eagletrt/bms-monitor/bms_monitor.kicad_pcb

## KiCad design bms_monitor.kicad_pcb (2023-05-23)

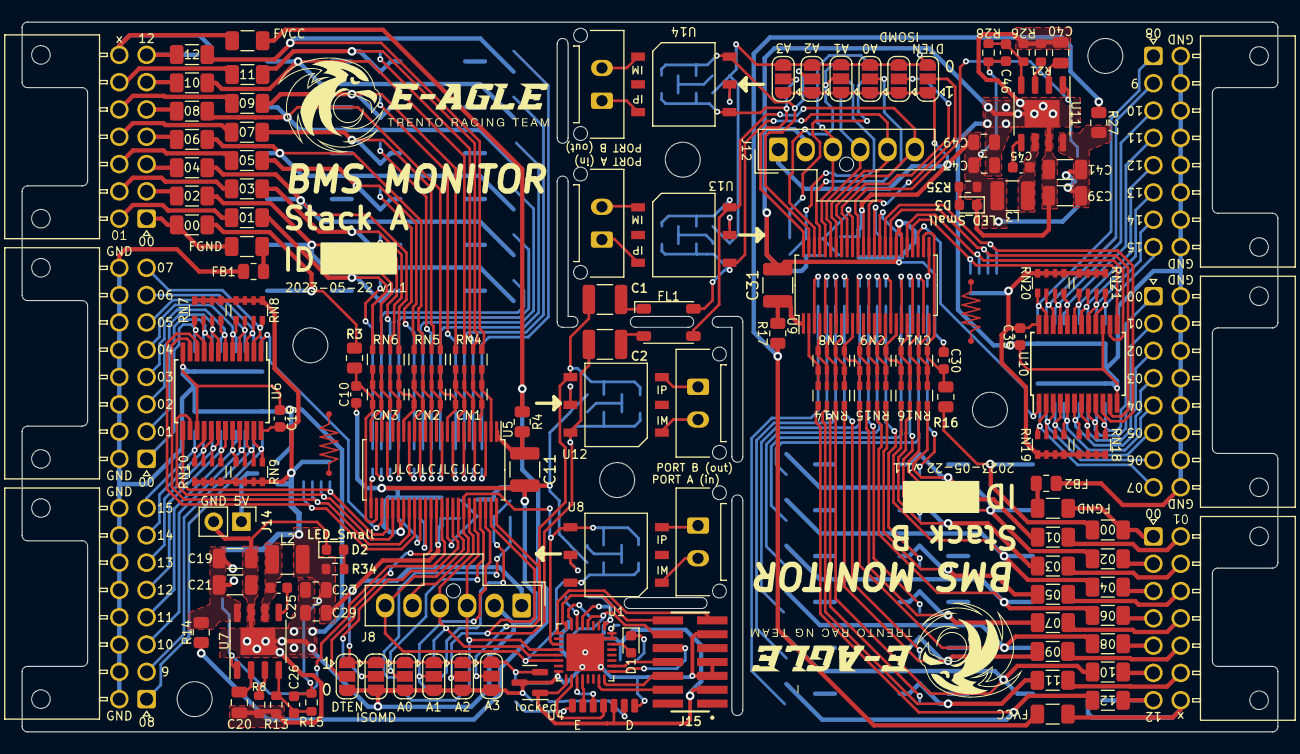
[picture p1: board bms_monitor.kicad_pcb from above]

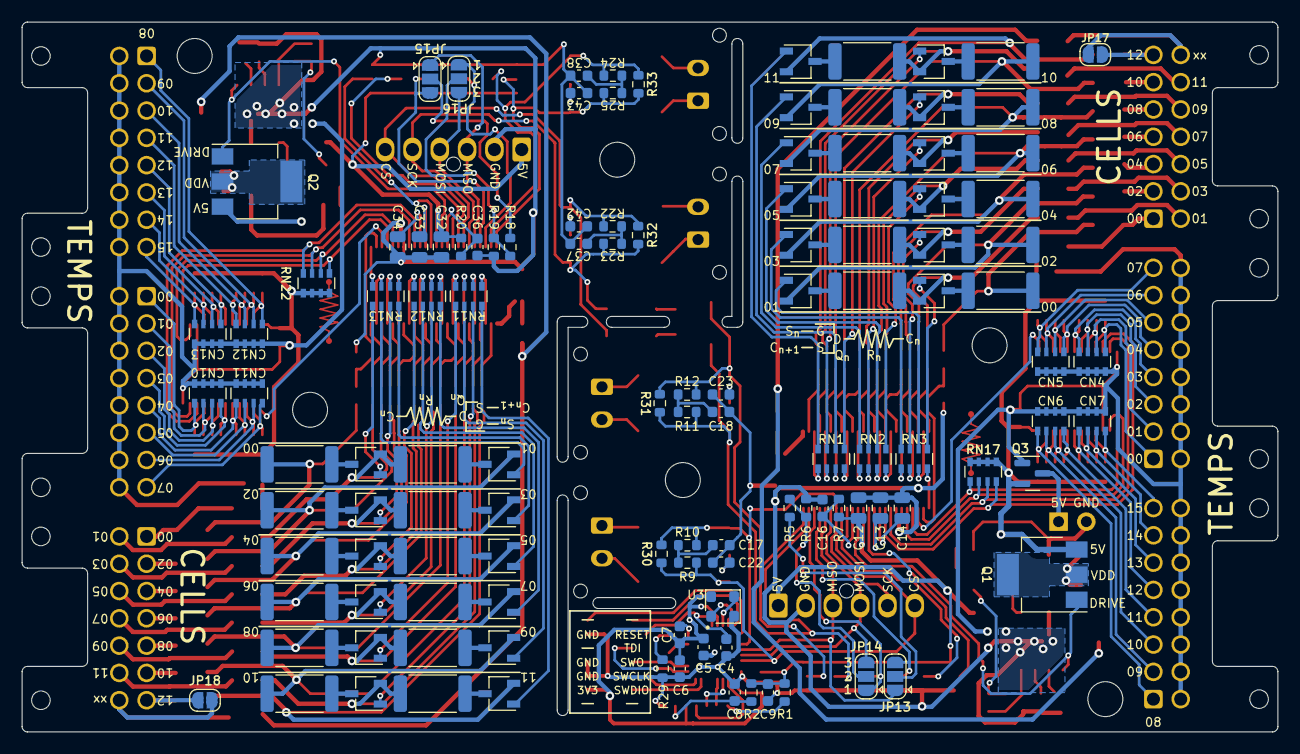
[picture p2: board bms_monitor.kicad_pcb from below]

Board: 2 copper layers, 115.0 x 65.0 mm, 256 parts (117 on the bottom side), 286 nets.

Parts:
C1, C2: 10nF 100V; C_1210_3225Metric
C4, C5, C6, C7, C8, C9, C15, C25, C35, C45: 100nF; C_0603_1608Metric
C10, C17, C18, C22, C23, C30, C37, C38, C42, C43: 10nF; C_0603_1608Metric
C11, C31: 100nF 100V; C_1210_3225Metric
C12, C13, C14, C20, C32, C33, C34, C40: 1uF; C_0805_2012Metric
C16, C36: F; C_0603_1608Metric
C19, C21, C39, C41: 1uF 100V; C_1206_3216Metric
C26, C46: 680pF; C_0603_1608Metric
C27, C29, C47, C49: 10uF; C_0805_2012Metric
CN1, CN2, CN3, CN8, CN9, CN14: 10nF; R_Array_Convex_4x0603
CN4, CN5, CN6, CN7, CN10, CN11, CN12, CN13: 100nF; R_Array_Convex_4x0603
D1: LED; LED_0603_1608Metric
D2, D3: LED_Small; LED_0603_1608Metric
F13, F14, F15, F16, F17, F18, F19, F20, F21, F22, F23, F24, F25: 2A; Fuse_1206_3216Metric
FB1, FB2: 600R; R_0805_2012Metric
FL1: ACT45B-101-2P-TL003; ACT45B-xxx-2P-TL003
Fa0, Fa1, Fa2, Fa3, Fa4, Fa5, Fa6, Fa7, Fa8, Fa9, Fa10, Fa11, Fa12, Fa13, Fa14: 2A; Fuse_1206_3216Metric
Fb3, Fb14: 2A; Fuse_1206_3216Metric
H1, H2, H3, H4, H5, H6: MountingHole; MountingHole_3.2mm_M3_ISO14580
J1, J2, J3, J4: Conn_01x02; Molex_Micro-Fit_3.0_43650-0215_1x02_P3.00mm_Vertical
J5, J9: CELLS; Molex_Nano-Fit_105314-xx14_2x07_P2.50mm_Horizontal
J6, J10: TEMP0; Molex_Nano-Fit_105314-xx16_2x08_P2.50mm_Horizontal
J7, J11: TEMP1; Molex_Nano-Fit_105314-xx16_2x08_P2.50mm_Horizontal
J8, J12: Conn_01x05; Molex_Nano-Fit_105309-xx06_1x06_P2.50mm_Vertical
J14: 5V; PinHeader_1x02_P2.54mm_Vertical
J15: Conn_ST_STDC14; SAMTEC_FTSH-107-01-L-DV-K-TR
JP1, JP7: A0; SolderJumper-3_P1.3mm_Open_RoundedPad1.0x1.5mm
JP2, JP8: A1; SolderJumper-3_P1.3mm_Open_RoundedPad1.0x1.5mm
JP3, JP9: A2; SolderJumper-3_P1.3mm_Open_RoundedPad1.0x1.5mm
JP4, JP10: A3; SolderJumper-3_P1.3mm_Open_RoundedPad1.0x1.5mm
JP5, JP11: DTEN; SolderJumper-3_P1.3mm_Open_RoundedPad1.0x1.5mm
JP6, JP12: ISOMD; SolderJumper-3_P1.3mm_Open_RoundedPad1.0x1.5mm
JP13, JP15: IBIAS; SolderJumper-3_P1.3mm_Open_RoundedPad1.0x1.5mm
JP14, JP16: ICMP; SolderJumper-3_P1.3mm_Open_RoundedPad1.0x1.5mm
JP17, JP18: isoIP; SolderJumper-2_P1.3mm_Open_RoundedPad1.0x1.5mm
L2, L3: 33uH; L_1210_3225Metric
Q1, Q2: NSS1C201MZ4; SOT-223
Q3: PMV65XP; SOT-23
Qda0, Qda1, Qda2, Qda3, Qda4, Qda5, Qda6, Qda7, Qda8, Qda9, Qda10, Qda11: BSS308PE; TSOT-23
Qdb0, Qdb1, Qdb2, Qdb3, Qdb4, Qdb5, Qdb6, Qdb7, Qdb8, Qdb9, Qdb10, Qdb11: BSS308PE; TSOT-23
R1, R2: 47R; R_0603_1608Metric
R3, R4, R14, R16, R17, R27: 100R; R_0805_2012Metric
R5, R6, R7, R18, R19, R20, R29: R; R_0603_1608Metric
R8, R21: 82k; R_0603_1608Metric
R9, R10, R11, R12, R22, R23, R24, R25: 51R; R_0603_1608Metric
R13, R26: 10k; R_0603_1608Metric
R15, R28: 39k; R_0603_1608Metric
R30, R31, R32, R33: 100; R_0603_1608Metric
R34, R35: 1K; R_0603_1608Metric
RN1, RN2, RN3, RN11, RN12, RN13: 3.3K; R_Array_Convex_4x0603
RN4, RN5, RN6, RN14, RN15, RN16: 100R; R_Array_Convex_4x0603
RN7, RN8, RN9, RN10, RN18, RN19, RN20, RN21: 27K; R_Array_Convex_4x0603
RN17, RN22: 10K; R_Array_Convex_4x0603
Rda0, Rda1, Rda2, Rda3, Rda4, Rda5, Rda6, Rda7, Rda8, Rda9, Rda10, Rda11: 10R; R_2512_6332Metric
Rdb0, Rdb1, Rdb2, Rdb3, Rdb4, Rdb5, Rdb6, Rdb7, Rdb8, Rdb9, Rdb10, Rdb11: 10R; R_2512_6332Metric
U1: STM32L432KBUx; QFN-32-1EP_5x5mm_P0.5mm_EP3.45x3.45mm
U3: DSC61XX; VLGA-4_2x2.5mm_P1.65mm
U4: TFBS4652
U5, U9: LTC6811-1; SSOP-48_5.3x12.8mm_P0.5mm
U6, U10: 74HC4067PW,118; SSOP-24_5.3x8.2mm_P0.65mm
U7, U11: MP4541; SOIC-8-1EP_3.9x4.9mm_P1.27mm_EP2.514x3.2mm
U8, U12, U13, U14: SM91502ALA
locked: MCP1812AT-033-TT; SOT-23

Connections:
+3.3V: C5.1, C6.1, C7.1, J15.3 (VCC), U1.1 (VDD), U1.5 (VDDA), U1.17 (VDD), U3.4 (VDD), U4.5 (VCCIO), locked.1 (Vout)
+5V: C9.1, C12.2, C15.2, C26.1, C27.1, C29.1, J8.1, JP1.1 (A), JP2.1 (A), JP3.1 (A), JP4.1 (A), JP5.1 (A), JP6.1 (A), L2.2, Q1.3 (E), Q3.2 (S), R1.2, R2.2, R7.1, R15.1, R34.1, RN7.1 (R1.1), RN7.2 (R2.1), RN7.3 (R3.1), RN7.4 (R4.1), RN8.1 (R1.1), RN8.2 (R2.1), RN8.3 (R3.1), RN8.4 (R4.1), RN9.1 (R1.1), RN9.2 (R2.1), RN9.3 (R3.1), RN9.4 (R4.1), RN10.1 (R1.1), RN10.2 (R2.1), RN10.3 (R3.1), RN10.4 (R4.1), RN17.1 (R1.1), RN17.2 (R2.1), RN17.3 (R3.1), RN17.4 (R4.1), U5.37 (VREG), U6.24 (VCC), locked.2 (Vin)
/CLK: U1.6 (PA0), U3.3 (OUT)
/CS: J8.6, R9.1, R30.1, U1.14 (PB0), U5.41 (CSB(IMA)), U8.6
/IA+_A: J8.5, R10.2, R30.2, U1.11 (PA5), U5.42 (SCK(IPA)), U8.4
/IAC_A: C22.2, U8.5
/IB+_B: JP10.2 (C), R25.2, R33.2, U9.48 (IPB), U14.4
/IB-_B: JP9.2 (C), R24.1, R33.1, U9.47 (IMB), U14.6
/IBC_B: C43.2, U14.5
/MISO: J8.3, JP13.1 (A), U1.12 (PA6), U5.44 (SDO(NC))
/MOSI: J8.4, JP14.3 (B), U1.13 (PA7), U5.43 (SDI(NC))
/STACK_A_IA+: J3.1, U8.3
/STACK_A_IA-: J3.2, U8.1
/STACK_A_IB+: J4.1, U12.3
/STACK_A_IB-: J4.2, U12.1
/STACK_B_IA+: J1.1, U13.3
/STACK_B_IA-: J1.2, U13.1
/STACK_B_IB+: J2.1, U14.3
/STACK_B_IB-: J2.2, U14.1
/SWCLK: J15.6 (JCLK/SWCLK), U1.24 (PA14)
/SWDIO: J15.4 (JTMS/SWDIO), U1.23 (PA13)
/SWO: J15.8 (JTDO/SWO), U1.26 (PB3)
/StackA/A0: JP1.2 (C), JP13.3 (B), U5.45 (IBIAS)
/StackA/A1: JP2.2 (C), JP14.1 (A), U5.46 (ICMP)
/StackA/A2: C2.1, JP3.2 (C), R11.1, R31.1, U5.47 (IMB), U12.6
/StackA/A3: C1.1, JP4.2 (C), R12.2, R31.2, U5.48 (IPB), U12.4
/StackA/C00: C10.2, CN3.1 (R1.1), R3.2, U5.26 (C0)
/StackA/C01: CN3.2 (R2.1), CN3.8 (R1.2), RN6.1 (R1.1), U5.24 (C1)
/StackA/C02: CN3.3 (R3.1), CN3.7 (R2.2), RN6.2 (R2.1), U5.22 (C2)
/StackA/C03: CN3.4 (R4.1), CN3.6 (R3.2), RN6.3 (R3.1), U5.20 (C3)
/StackA/C04: CN2.1 (R1.1), CN3.5 (R4.2), RN6.4 (R4.1), U5.18 (C4)
/StackA/C05: CN2.2 (R2.1), CN2.8 (R1.2), RN5.1 (R1.1), U5.16 (C5)
/StackA/C06: CN2.3 (R3.1), CN2.7 (R2.2), RN5.2 (R2.1), U5.14 (C6)
/StackA/C07: CN2.4 (R4.1), CN2.6 (R3.2), RN5.3 (R3.1), U5.12 (C7)
/StackA/C08: CN1.1 (R1.1), CN2.5 (R4.2), RN5.4 (R4.1), U5.10 (C8)
/StackA/C09: CN1.2 (R2.1), CN1.8 (R1.2), RN4.1 (R1.1), U5.8 (C9)
/StackA/C10: CN1.3 (R3.1), CN1.7 (R2.2), RN4.2 (R2.1), U5.6 (C10)
/StackA/C11: CN1.4 (R4.1), CN1.6 (R3.2), RN4.3 (R3.1), U5.4 (C11)
/StackA/C12: CN1.5 (R4.2), RN4.4 (R4.1), U5.2 (C12)
/StackA/CC00: Fa0.1, R3.1, Rda0.2
/StackA/CC01: Fa1.1, Qda0.2 (S), RN6.8 (R1.2), Rda1.2
/StackA/CC02: Fa2.1, Qda1.2 (S), RN6.7 (R2.2), Rda2.2
/StackA/CC03: Fa3.1, Qda2.2 (S), RN6.6 (R3.2), Rda3.2
/StackA/CC04: Fa4.1, Qda3.2 (S), RN6.5 (R4.2), Rda4.2
/StackA/CC05: Fa5.1, Qda4.2 (S), RN5.8 (R1.2), Rda5.2
/StackA/CC06: Fa6.1, Qda5.2 (S), RN5.7 (R2.2), Rda6.2
/StackA/CC07: Fa7.1, Qda6.2 (S), RN5.6 (R3.2), Rda7.2
/StackA/CC08: Fa8.1, Qda7.2 (S), RN5.5 (R4.2), Rda8.2
/StackA/CC09: Fa9.1, Qda8.2 (S), RN4.8 (R1.2), Rda9.2
/StackA/CC10: Fa10.1, Qda9.2 (S), RN4.7 (R2.2), Rda10.2
/StackA/CC11: Fa11.1, Qda10.2 (S), RN4.6 (R3.2), Rda11.2
/StackA/CC12: Fa12.1, Qda11.2 (S), RN4.5 (R4.2)
/StackA/DRIVE: Q1.1 (B), U5.38 (DRIVE), U7.1 (EN)
/StackA/DTEN: JP5.2 (C), U5.36 (SWTEN)
/StackA/IBC: C23.2, U12.5
/StackA/ISOMD: JP6.2 (C), U5.40 (ISOMD)
/StackA/MUX_A0: RN17.8 (R1.2), U5.33 (GPIO5), U6.10 (S0)
/StackA/MUX_A1: RN17.7 (R2.2), U5.32 (GPIO4), U6.11 (S1)
/StackA/MUX_A2: RN17.6 (R3.2), U5.29 (GPIO3), U6.14 (S2)
/StackA/MUX_A3: RN17.5 (R4.2), U5.28 (GPIO2), U6.13 (S3)
/StackA/MUX_OUT: U5.27 (GPIO1), U6.1 (COM)
/StackA/PSU_INPUT: C19.1, C21.1, Q1.2 (C), Q1.4 (C), R14.2, U7.8 (VIN)
/StackA/S00: RN3.8 (R1.2), U5.25 (S1)
/StackA/S01: RN3.7 (R2.2), U5.23 (S2)
/StackA/S02: RN3.6 (R3.2), U5.21 (S3)
/StackA/S03: RN3.5 (R4.2), U5.19 (S4)
/StackA/S04: RN2.8 (R1.2), U5.17 (S5)
/StackA/S05: RN2.7 (R2.2), U5.15 (S6)
/StackA/S06: RN2.6 (R3.2), U5.13 (S7)
/StackA/S07: RN2.5 (R4.2), U5.11 (S8)
/StackA/S08: RN1.8 (R1.2), U5.9 (S9)
/StackA/S09: RN1.7 (R2.2), U5.7 (S10)
/StackA/S10: RN1.6 (R3.2), U5.5 (S11)
/StackA/S11: RN1.5 (R4.2), U5.3 (S12)
/StackA/VDD: Fa13.1, R4.1, R14.1
/StackA/WDT: C16.1, R7.2, U5.39 (WDT)
/StackB/A0: JP7.2 (C), JP15.3 (B), U9.45 (IBIAS)
/StackB/A1: JP8.2 (C), JP16.1 (A), U9.46 (ICMP)
/StackB/C00: C30.2, CN14.1 (R1.1), R16.2, U9.26 (C0)
/StackB/C01: CN14.2 (R2.1), CN14.8 (R1.2), RN16.1 (R1.1), U9.24 (C1)
/StackB/C02: CN14.3 (R3.1), CN14.7 (R2.2), RN16.2 (R2.1), U9.22 (C2)
/StackB/C03: CN14.4 (R4.1), CN14.6 (R3.2), RN16.3 (R3.1), U9.20 (C3)
/StackB/C04: CN9.1 (R1.1), CN14.5 (R4.2), RN16.4 (R4.1), U9.18 (C4)
/StackB/C05: CN9.2 (R2.1), CN9.8 (R1.2), RN15.1 (R1.1), U9.16 (C5)
/StackB/C06: CN9.3 (R3.1), CN9.7 (R2.2), RN15.2 (R2.1), U9.14 (C6)
/StackB/C07: CN9.4 (R4.1), CN9.6 (R3.2), RN15.3 (R3.1), U9.12 (C7)
/StackB/C08: CN8.1 (R1.1), CN9.5 (R4.2), RN15.4 (R4.1), U9.10 (C8)
/StackB/C09: CN8.2 (R2.1), CN8.8 (R1.2), RN14.1 (R1.1), U9.8 (C9)
/StackB/C10: CN8.3 (R3.1), CN8.7 (R2.2), RN14.2 (R2.1), U9.6 (C10)
/StackB/C11: CN8.4 (R4.1), CN8.6 (R3.2), RN14.3 (R3.1), U9.4 (C11)
/StackB/C12: CN8.5 (R4.2), RN14.4 (R4.1), U9.2 (C12)
/StackB/CC00: F19.1, R16.1, Rdb0.2
/StackB/CC01: F25.1, Qdb0.2 (S), RN16.8 (R1.2), Rdb1.2
/StackB/CC02: F18.1, Qdb1.2 (S), RN16.7 (R2.2), Rdb2.2
/StackB/CC03: F24.1, Qdb2.2 (S), RN16.6 (R3.2), Rdb3.2
/StackB/CC04: F17.1, Qdb3.2 (S), RN16.5 (R4.2), Rdb4.2
/StackB/CC05: F23.1, Qdb4.2 (S), RN15.8 (R1.2), Rdb5.2
/StackB/CC06: F16.1, Qdb5.2 (S), RN15.7 (R2.2), Rdb6.2
/StackB/CC07: F22.1, Qdb6.2 (S), RN15.6 (R3.2), Rdb7.2
/StackB/CC08: F15.1, Qdb7.2 (S), RN15.5 (R4.2), Rdb8.2
/StackB/CC09: F21.1, Qdb8.2 (S), RN14.8 (R1.2), Rdb9.2
/StackB/CC10: F14.1, Qdb9.2 (S), RN14.7 (R2.2), Rdb10.2
/StackB/CC11: F20.1, Qdb10.2 (S), RN14.6 (R3.2), Rdb11.2
/StackB/CC12: F13.1, Qdb11.2 (S), RN14.5 (R4.2)
/StackB/CSB: FL1.3, J12.6, R22.1, R32.1, U9.41 (CSB(IMA)), U13.6
/StackB/DRIVE: Q2.1 (B), U9.38 (DRIVE), U11.1 (EN)
/StackB/DTEN: JP11.2 (C), U9.36 (SWTEN)
/StackB/GND: C30.1, C31.2, C32.1, C33.1, C34.1, C35.1, C36.2, C37.2, C38.2, C39.2, C40.2, C41.2, C42.1, C43.1, C47.2, C49.2, CN10.1 (R1.1), CN10.2 (R2.1), CN10.3 (R3.1), CN10.4 (R4.1), CN11.1 (R1.1), CN11.2 (R2.1), CN11.3 (R3.1), CN11.4 (R4.1), CN12.1 (R1.1), CN12.2 (R2.1), CN12.3 (R3.1), CN12.4 (R4.1), CN13.1 (R1.1), CN13.2 (R2.1), CN13.3 (R3.1), CN13.4 (R4.1), D3.1 (K), FB2.2, J10.9, J10.10, J10.11, J10.12, J10.13, J10.14, J10.15, J10.16, J11.9, J11.10, J11.11, J11.12, J11.13, J11.14, J11.15, J11.16, J12.2, JP7.3 (B), JP8.3 (B), JP9.3 (B), JP10.3 (B), JP11.3 (B), JP12.3 (B), R19.1, R21.1, R26.1, U9.30 (V-), U9.31 (V-), U10.12 (GND), U10.15 (~E), U11.7 (GND), U11.9 (EP)
/StackB/IA+: FL1.4, J12.5, R23.2, R32.2, U9.42 (SCK(IPA)), U13.4
/StackB/IAC: C42.2, U13.5
/StackB/IBIAS_2: J12.3, JP15.1 (A), U9.44 (SDO(NC))
/StackB/ICMP_2: J12.4, JP16.3 (B), U9.43 (SDI(NC))
/StackB/ISOMD: JP12.2 (C), U9.40 (ISOMD)
/StackB/MUX_A0: RN22.8 (R1.2), U9.33 (GPIO5), U10.10 (S0)
/StackB/MUX_A1: RN22.7 (R2.2), U9.32 (GPIO4), U10.11 (S1)
/StackB/MUX_A2: RN22.6 (R3.2), U9.29 (GPIO3), U10.14 (S2)
/StackB/MUX_A3: RN22.5 (R4.2), U9.28 (GPIO2), U10.13 (S3)
/StackB/MUX_OUT: U9.27 (GPIO1), U10.1 (COM)
/StackB/PSU_INPUT: C39.1, C41.1, Q2.2 (C), Q2.4 (C), R27.2, U11.8 (VIN)
/StackB/S00: RN13.8 (R1.2), U9.25 (S1)
/StackB/S01: RN13.7 (R2.2), U9.23 (S2)
/StackB/S02: RN13.6 (R3.2), U9.21 (S3)
/StackB/S03: RN13.5 (R4.2), U9.19 (S4)
/StackB/S04: RN12.8 (R1.2), U9.17 (S5)
/StackB/S05: RN12.7 (R2.2), U9.15 (S6)
/StackB/S06: RN12.6 (R3.2), U9.13 (S7)
/StackB/S07: RN12.5 (R4.2), U9.11 (S8)
/StackB/S08: RN11.8 (R1.2), U9.9 (S9)
/StackB/S09: RN11.7 (R2.2), U9.7 (S10)
/StackB/S10: RN11.6 (R3.2), U9.5 (S11)
/StackB/S11: RN11.5 (R4.2), U9.3 (S12)
/StackB/VCC: C32.2, C35.2, C46.1, C47.1, C49.1, J12.1, JP7.1 (A), JP8.1 (A), JP9.1 (A), JP10.1 (A), JP11.1 (A), JP12.1 (A), L3.2, Q2.3 (E), R20.1, R28.1, R35.1, RN18.1 (R1.1), RN18.2 (R2.1), RN18.3 (R3.1), RN18.4 (R4.1), RN19.1 (R1.1), RN19.2 (R2.1), RN19.3 (R3.1), RN19.4 (R4.1), RN20.1 (R1.1), RN20.2 (R2.1), RN20.3 (R3.1), RN20.4 (R4.1), RN21.1 (R1.1), RN21.2 (R2.1), RN21.3 (R3.1), RN21.4 (R4.1), RN22.1 (R1.1), RN22.2 (R2.1), RN22.3 (R3.1), RN22.4 (R4.1), U9.37 (VREG), U10.24 (VCC)
/StackB/VDD: Fb3.1, R17.1, R27.1
/StackB/WDT: C36.1, R20.2, U9.39 (WDT)
/TDI: J15.10 (JTDI/NC), U1.25 (PA15)
/UART2_RX: J15.13 (VCP_RX), U1.9 (PA3)
/UART2_TX: J15.14 (VCP_TX), U1.8 (PA2)
/~RESET: C4.2, J15.12 (~RST), U1.4 (NRST)
GND: C4.1, C5.2, C6.2, C7.2, C8.2, C9.2, C10.1, C11.2, C12.1, C13.1, C14.1, C15.1, C16.2, C17.2, C18.2, C19.2, C20.2, C21.2, C22.1, C23.1, C27.2, C29.2, CN4.1 (R1.1), CN4.2 (R2.1), CN4.3 (R3.1), CN4.4 (R4.1), CN5.1 (R1.1), CN5.2 (R2.1), CN5.3 (R3.1), CN5.4 (R4.1), CN6.1 (R1.1), CN6.2 (R2.1), CN6.3 (R3.1), CN6.4 (R4.1), CN7.1 (R1.1), CN7.2 (R2.1), CN7.3 (R3.1), CN7.4 (R4.1), D2.1 (K), FB1.2, J6.9, J6.10, J6.11, J6.12, J6.13, J6.14, J6.15, J6.16, J7.9, J7.10, J7.11, J7.12, J7.13, J7.14, J7.15, J7.16, J8.2, J14.2, J15.5 (GND), J15.7 (GND), J15.11 (GNDDetect), JP1.3 (B), JP2.3 (B), JP3.3 (B), JP4.3 (B), JP5.3 (B), JP6.3 (B), Q3.1 (G), R6.1, R8.1, R13.1, R29.2, U1.16 (VSS), U1.31 (PH3), U1.32 (VSS), U1.33 (VSS), U3.2 (GND), U4.7 (GND), U5.30 (V-), U5.31 (V-), U6.12 (GND), U6.15 (~E), U7.7 (GND), U7.9 (EP), locked.3 (GND)
unnamed: C1.2, FL1.1
unnamed: C2.2, FL1.2
unnamed: C8.1, R2.1, U4.6 (VCC)
unnamed: C11.1, R4.2, U5.1 (V+)
unnamed: C13.2, U5.35 (VREF1)
unnamed: C14.2, U5.34 (VREF2)
unnamed: C17.1, R9.2, R10.1
unnamed: C18.1, R11.2, R12.1
unnamed: C20.1, U7.2 (VCC)
unnamed: C25.1, U7.5 (BST)
unnamed: C25.2, L2.1, U7.6 (SW)
unnamed: C26.2, R13.2, R15.2, U7.4 (FB)
unnamed: C31.1, R17.2, U9.1 (V+)
unnamed: C33.2, U9.35 (VREF1)
unnamed: C34.2, U9.34 (VREF2)
unnamed: C37.1, R22.2, R23.1
unnamed: C38.1, R24.2, R25.1
unnamed: C40.1, U11.2 (VCC)
unnamed: C45.1, U11.5 (BST)
unnamed: C45.2, L3.1, U11.6 (SW)
unnamed: C46.2, R26.2, R28.2, U11.4 (FB)
unnamed: CN4.5 (R4.2), J7.1, RN7.5 (R4.2), U6.9 (I0)
unnamed: CN4.6 (R3.2), J7.2, RN7.6 (R3.2), U6.8 (I1)
unnamed: CN4.7 (R2.2), J7.3, RN7.7 (R2.2), U6.7 (I2)
unnamed: CN4.8 (R1.2), J7.4, RN7.8 (R1.2), U6.6 (I3)
unnamed: CN5.5 (R4.2), J7.5, RN8.5 (R4.2), U6.5 (I4)
unnamed: CN5.6 (R3.2), J7.6, RN8.6 (R3.2), U6.4 (I5)
unnamed: CN5.7 (R2.2), J7.7, RN8.7 (R2.2), U6.3 (I6)
unnamed: CN5.8 (R1.2), J7.8, RN8.8 (R1.2), U6.2 (I7)
unnamed: CN6.5 (R4.2), J6.1, RN9.5 (R4.2), U6.23 (I8)
unnamed: CN6.6 (R3.2), J6.2, RN9.6 (R3.2), U6.22 (I9)
unnamed: CN6.7 (R2.2), J6.3, RN9.7 (R2.2), U6.21 (I10)
unnamed: CN6.8 (R1.2), J6.4, RN9.8 (R1.2), U6.20 (I11)
unnamed: CN7.5 (R4.2), J6.5, RN10.5 (R4.2), U6.19 (I12)
unnamed: CN7.6 (R3.2), J6.6, RN10.6 (R3.2), U6.18 (I13)
unnamed: CN7.7 (R2.2), J6.7, RN10.7 (R2.2), U6.17 (I14)
unnamed: CN7.8 (R1.2), J6.8, RN10.8 (R1.2), U6.16 (I15)
unnamed: CN10.5 (R4.2), J11.1, RN18.5 (R4.2), U10.9 (I0)
unnamed: CN10.6 (R3.2), J11.2, RN18.6 (R3.2), U10.8 (I1)
unnamed: CN10.7 (R2.2), J11.3, RN18.7 (R2.2), U10.7 (I2)
unnamed: CN10.8 (R1.2), J11.4, RN18.8 (R1.2), U10.6 (I3)
unnamed: CN11.5 (R4.2), J11.5, RN19.5 (R4.2), U10.5 (I4)
unnamed: CN11.6 (R3.2), J11.6, RN19.6 (R3.2), U10.4 (I5)
unnamed: CN11.7 (R2.2), J11.7, RN19.7 (R2.2), U10.3 (I6)
unnamed: CN11.8 (R1.2), J11.8, RN19.8 (R1.2), U10.2 (I7)
unnamed: CN12.5 (R4.2), J10.1, RN20.5 (R4.2), U10.23 (I8)
unnamed: CN12.6 (R3.2), J10.2, RN20.6 (R3.2), U10.22 (I9)
unnamed: CN12.7 (R2.2), J10.3, RN20.7 (R2.2), U10.21 (I10)
unnamed: CN12.8 (R1.2), J10.4, RN20.8 (R1.2), U10.20 (I11)
unnamed: CN13.5 (R4.2), J10.5, RN21.5 (R4.2), U10.19 (I12)
unnamed: CN13.6 (R3.2), J10.6, RN21.6 (R3.2), U10.18 (I13)
unnamed: CN13.7 (R2.2), J10.7, RN21.7 (R2.2), U10.17 (I14)
unnamed: CN13.8 (R1.2), J10.8, RN21.8 (R1.2), U10.16 (I15)
unnamed: D1.1 (K), R29.1
unnamed: D1.2 (A), U1.30 (PB7)
unnamed: D2.2 (A), R34.2
unnamed: D3.2 (A), R35.2
unnamed: F13.2, J9.7, JP18.1 (A)
unnamed: F14.2, J9.6
unnamed: F15.2, J9.5
unnamed: F16.2, J9.4
unnamed: F17.2, J9.3
unnamed: F18.2, J9.2
unnamed: F19.2, Fb14.2, J9.1
unnamed: F20.2, J9.13
unnamed: F21.2, J9.12
unnamed: F22.2, J9.11
unnamed: F23.2, J9.10
unnamed: F24.2, J9.9
unnamed: F25.2, J9.8
unnamed: FB1.1, Fa14.1
unnamed: FB2.1, Fb14.1
unnamed: Fa0.2, Fa14.2, J5.1
unnamed: Fa1.2, J5.8
unnamed: Fa2.2, J5.2
unnamed: Fa3.2, J5.9
unnamed: Fa4.2, J5.3
unnamed: Fa5.2, J5.10
unnamed: Fa6.2, J5.4
unnamed: Fa7.2, J5.11
unnamed: Fa8.2, J5.5
unnamed: Fa9.2, J5.12
unnamed: Fa10.2, J5.6
unnamed: Fa11.2, J5.13
unnamed: Fa12.2, J5.7, JP17.1 (A)
unnamed: Fa13.2, J5.14, JP17.2 (B)
unnamed: Fb3.2, J9.14, JP18.2 (B)
unnamed: J14.1, Q3.3 (D)
unnamed: JP13.2 (C), R5.2
unnamed: JP14.2 (C), R5.1, R6.2
unnamed: JP15.2 (C), R18.2
unnamed: JP16.2 (C), R18.1, R19.2
unnamed: Qda0.1 (G), RN3.1 (R1.1)
unnamed: Qda0.3 (D), Rda0.1
unnamed: Qda1.1 (G), RN3.2 (R2.1)
unnamed: Qda1.3 (D), Rda1.1
unnamed: Qda2.1 (G), RN3.3 (R3.1)
unnamed: Qda2.3 (D), Rda2.1
unnamed: Qda3.1 (G), RN3.4 (R4.1)
unnamed: Qda3.3 (D), Rda3.1
unnamed: Qda4.1 (G), RN2.1 (R1.1)
unnamed: Qda4.3 (D), Rda4.1
unnamed: Qda5.1 (G), RN2.2 (R2.1)
unnamed: Qda5.3 (D), Rda5.1
unnamed: Qda6.1 (G), RN2.3 (R3.1)
unnamed: Qda6.3 (D), Rda6.1
unnamed: Qda7.1 (G), RN2.4 (R4.1)
unnamed: Qda7.3 (D), Rda7.1
unnamed: Qda8.1 (G), RN1.1 (R1.1)
unnamed: Qda8.3 (D), Rda8.1
unnamed: Qda9.1 (G), RN1.2 (R2.1)
unnamed: Qda9.3 (D), Rda9.1
unnamed: Qda10.1 (G), RN1.3 (R3.1)
unnamed: Qda10.3 (D), Rda10.1
unnamed: Qda11.1 (G), RN1.4 (R4.1)
unnamed: Qda11.3 (D), Rda11.1
unnamed: Qdb0.1 (G), RN13.1 (R1.1)
unnamed: Qdb0.3 (D), Rdb0.1
unnamed: Qdb1.1 (G), RN13.2 (R2.1)
unnamed: Qdb1.3 (D), Rdb1.1
unnamed: Qdb2.1 (G), RN13.3 (R3.1)
unnamed: Qdb2.3 (D), Rdb2.1
unnamed: Qdb3.1 (G), RN13.4 (R4.1)
unnamed: Qdb3.3 (D), Rdb3.1
unnamed: Qdb4.1 (G), RN12.1 (R1.1)
unnamed: Qdb4.3 (D), Rdb4.1
unnamed: Qdb5.1 (G), RN12.2 (R2.1)
unnamed: Qdb5.3 (D), Rdb5.1
unnamed: Qdb6.1 (G), RN12.3 (R3.1)
unnamed: Qdb6.3 (D), Rdb6.1
unnamed: Qdb7.1 (G), RN12.4 (R4.1)
unnamed: Qdb7.3 (D), Rdb7.1
unnamed: Qdb8.1 (G), RN11.1 (R1.1)
unnamed: Qdb8.3 (D), Rdb8.1
unnamed: Qdb9.1 (G), RN11.2 (R2.1)
unnamed: Qdb9.3 (D), Rdb9.1
unnamed: Qdb10.1 (G), RN11.3 (R3.1)
unnamed: Qdb10.3 (D), Rdb10.1
unnamed: Qdb11.1 (G), RN11.4 (R4.1)
unnamed: Qdb11.3 (D), Rdb11.1
unnamed: R1.1, U4.1 (IREDA)
unnamed: R8.2, U7.3 (FREQ)
unnamed: R21.2, U11.3 (FREQ)
unnamed: U1.7 (PA1), U3.1 (OE)
unnamed: U1.18 (PA8), U4.4 (SD)
unnamed: U1.19 (PA9), U4.3 (TXD)
unnamed: U1.20 (PA10), U4.2 (RXD)
