eagletrt/bms-monitor/(threads)

Thread 1 (2023-03-09):

Schematic review

Kirseline, 2023-03-09:
LTC6811-1
- [x] No Compatibility with LTC6811-2. Add IBIAS/ICMP on pin 44/43
- [x] Need clarification on the value of the Discharge resistor. I think that with that value it will dissipate to much power

DEBUG/PROGRAM
- [x] Consider using the same debug connector of the other boards
- [x] Add pin header to power the board during programming

why do you want to disable oscillator?

Closed 2023-05-17.

Thread 2 (2023-03-12):

PCB

Kirseline, 2023-03-12:
- [ ]  Change J6/J10 side when mounting because of  interference with other connectors
- [ ]  Resolve DRC violation when possible
- [ ]  Move designator outside hole pads

Thread 3 (2023-04-17):

Issues

thomasnonis, 2023-04-17:
- [ ] 100R on temperature dividers are not correct for our NTCs
- [ ] same for 10n caps. Cutoff frequency is too high

Kirseline, 2023-04-17:
- [ ] implement LTC's LED power indicator
