eagletrt/bms-monitor/(commit log)

2023-03-16 pre production
    - footprints change
    [bms_monitor.kicad_pcb, bms_monitor.kicad_sch, stack.kicad_sch]
2023-03-16 pre production
    footprint change
    [bms_monitor.kicad_pcb, bms_monitor.kicad_sch]
2023-03-17 production candidate
    - footprint change
    - added ltc6811-2 full compatibility
    [bms_monitor.kicad_pcb, bms_monitor.kicad_sch, stack.kicad_sch]
2023-03-20 Addition
    -Added USART 2 to Programming connector
    [bms_monitor.kicad_pcb, bms_monitor.kicad_sch]
2023-03-23 fix
    added ltc gpio pull up resistor
    [bms_monitor.kicad_pcb, bms_monitor.kicad_sch, stack.kicad_sch]
2023-03-24 fabrication
    added fabrication files
    [bms_monitor-B_Cu.gbl, bms_monitor-B_Mask.gbs, bms_monitor-B_Paste.gbp, bms_monitor-B_Silkscreen.gbo, bms_monitor-Edge_Cuts.gm1, bms_monitor-F_Cu.gtl, bms_monitor-F_Mask.gts, bms_monitor-F_Paste.gtp]
2023-03-24 fix
    - added pmos for reverse polarity protection to prog pwr
    - fixed temp connectors numbering (silkscreen)
    - regenerated fabrication files
    [bms_monitor-B_Cu.gbl, bms_monitor-B_Mask.gbs, bms_monitor-B_Paste.gbp, bms_monitor-B_Silkscreen.gbo, bms_monitor-Edge_Cuts.gm1, bms_monitor-F_Cu.gtl, bms_monitor-F_Mask.gts, bms_monitor-F_Paste.gtp]
2023-04-14 fab: update pcb for fabrication
    [bms_monitor-B_Cu.gbr, bms_monitor-B_Mask.gbr, bms_monitor-B_Paste.gbr, bms_monitor-B_Silkscreen.gbr, bms_monitor-Edge_Cuts.gbr, bms_monitor-F_Cu.gbr, bms_monitor-F_Mask.gbr, bms_monitor-F_Paste.gbr]
2023-05-22 fix
    - Changed oscillator footprint
    - tied mux enable to ground
    - Corrected power BJT's footprint
    - added 5V presence led
    [bms_monitor.kicad_pcb, bms_monitor.kicad_sch, stack.kicad_sch]
2023-05-23 upadate
    - updated fabrication output
    - added 3d models
    - updated bom
    [bms_monitor-B_Cu.gbr, bms_monitor-B_Mask.gbr, bms_monitor-B_Paste.gbr, bms_monitor-B_Silkscreen.gbr, bms_monitor-Edge_Cuts.gbr, bms_monitor-F_Cu.gbr, bms_monitor-F_Mask.gbr, bms_monitor-F_Paste.gbr]
